lianshuang-photo/esp32-claude-status-light/(commit log)

2026-06-17 Initial commit: ESP32-C3 Claude Code status light
    A Wi-Fi connected three-color desk light driven by Claude Code / Codex
    lifecycle hooks. Includes:
    - ESP32-C3 firmware (frame-animation protocol over TCP, 30s watchdog,
    multi-Wi-Fi failover)
    - Python daemon with priority-based multi-session aggregation, web UI
    on 127.0.0.1:7878, payload-driven failure detection on PostToolUse
    - Thin hook forwarder that returns in <100ms and never blocks the agent
    - Safe install_hooks.py with dry-run / preview / .bak backup / uninstall
    - Two LED effect profiles (vivid for demo, calm for desk use) with
    hot-switchable brightness, tempo, and agent filter
    - 19 of Claude Code's 29 hooks rout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
    [esp32c3_ai_status_led.ino, esp32c3_ai_status_led_debug.ino, esp32c3_signal_light.ino, esp32c3_signal_light_debug.ino]
2026-06-18 fw: replace analogWrite with software PWM to fix "OFF doesn't turn off"
    Symptom (observed on ESP32-C3 SuperMini):
    - Web UI / daemon correctly send {r:0,y:0,g:0}, board's serial confirms
    the frame is received and parsed, but two channels stay visibly lit.
    - Standalone GPIO probe sketches that only use digitalWrite work fine.
    - The issue only appears once the firmware has done at least one
    analogWrite() on each GPIO during animation playback.
    Root cause:
    Arduino-ESP32 implements analogWrite() by attaching the pin to an LEDC
    hardware PWM channel. Once that happens on ESP32-C3, subsequent
    digitalWrite() calls on the same pin become unreliable — the LEDC
    channel keeps emi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
    [esp32c3_signal_light.ino, esp32c3_signal_light_debug.ino]
2026-06-18 fw: move soft PWM into a hardware timer ISR + bump to 16 levels
    Symptom (observed on ESP32-C3 SuperMini with the previous loop-driven
    soft PWM): every ~1 second the LED would visibly "dip" briefly. The
    output between dips was correct, but the dip was distracting.
    Root cause: the PWM tick ran inside loop(). Anything else loop() did —
    Wi-Fi maintenance, TCP byte handling, periodic ping/pong, JSON parsing —
    stretched the gap between two consecutive PWM ticks. Whenever that gap
    got long enough (50-200 ms), the GPIO sat in whatever the last PWM slot
    left it in, and the human eye saw it as a flicker.
    Fix: drive the PWM from a hardware timer ISR (timerBegin/timerAlarm,
    auto-reload every 125 u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
    [esp32c3_signal_light.ino, esp32c3_signal_light_debug.ino]
2026-06-18 fw + daemon: hardware LEDC PWM, finite-blink effects, LAN sharing
    Firmware (both production and debug):
    - Drop the software-PWM-via-hardware-timer-ISR approach entirely.
    Even with IRAM_ATTR + direct GPIO register writes (out_w1ts/w1tc),
    a 16-level soft PWM at 125us tick was demonstrably unstable on
    ESP32-C3 under sustained Wi-Fi activity: about 11-12 cycles into a
    fast flash effect the LED would silently freeze with the wrong
    channel stuck on.
    - Switch to ESP32 LEDC hardware PWM via the low-level ledcAttach /
    ledcWrite API (NOT analogWrite, which corrupts subsequent
    digitalWrite calls on the same pin on ESP32-C3).
    - Guarantee a clean OFF by ledcDetach()-ing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
    [esp32c3_signal_light.ino, esp32c3_signal_light_debug.ino]
2026-06-18 ops: NVS-remembered Wi-Fi + 90 s watchdog + macOS LaunchAgent
    - Watchdog timeout raised from 30 s to 90 s. The old value was so
    tight that just restarting the daemon for development was enough
    to take the board down with it. 90 s tolerates a daemon bounce or
    a flaky network blip without rebooting the board.
    - Persist "which Wi-Fi network connected most recently" to NVS via
    Preferences. On the next boot we start with that index instead of
    walking the list from #0, which used to cost ~8 s of yellow-flash
    "connecting" time on every reboot when the first SSID is out of
    range. With the NVS hint, normal reboots reconnect in ~1 s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
    [esp32c3_signal_light.ino, esp32c3_signal_light_debug.ino]
2026-06-18 docs: TROUBLESHOOTING.md — every bug we hit and how we fixed it
    Captures the full debugging trail from a day of real hardware bring-up:
    LED:
    1.1 OFF doesn't actually turn off (analogWrite captures the GPIO)
    1.2 LED dips once per second (loop-driven soft PWM gets starved)
    1.3 Effect freezes after 11 blinks (digitalWrite is not in IRAM)
    1.4 Continuous flash is annoying (changed to 6-blink-then-hold)
    Wi-Fi / board:
    2.1 Board reboots every 30 s (different Wi-Fi from daemon)
    2.2 IP confusion: .197 vs .198 (one was board, the other was localhost!)
    2.3 90 s watchdog still loops (watchdog masks, doesn't fix reachability)
    USB / flashing:
    3.1 Board va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
2026-06-22 feat: BLE Wi-Fi provisioning via Web Bluetooth
    Lets anyone configure the board's Wi-Fi from a browser in 60 seconds —
    no recompile, no flashing, no hardcoded credentials. Works the same way
    commercial smart-home devices do.
    Firmware (debug only for now):
    - BLE GATT service "SignalLight-XXXX" with 3 characteristics:
    scan (read) → JSON list of nearby APs the board sees
    cmd (write) → {"ssid":"…","psk":"…"} from the configurator
    status (notify)→ {"state":"…","ip":"…"} progress feedback
    - Wi-Fi scan runs in loop() (not the BLE callback) and caches results
    so the GATT read returns instantly. Cache TTL 30 s.
    - Provisioned creds persist to NVS (Pref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
